GryposDE/Snail_v1/FV_Snail_v1.png

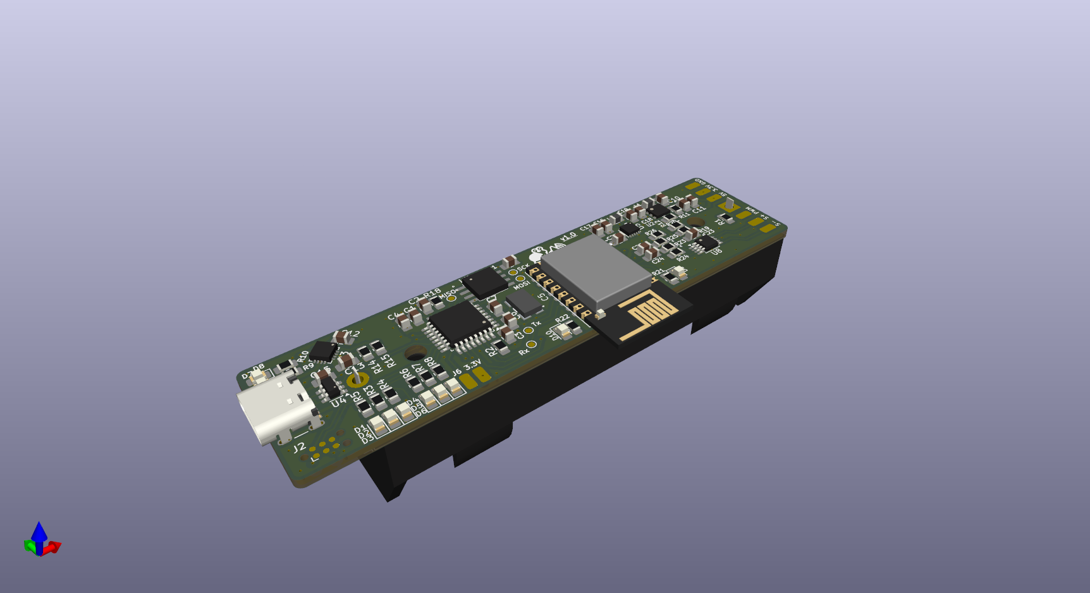
FV_Snail_v1.png
