GryposDE/Snail_v1/BV_Snail_v1.png

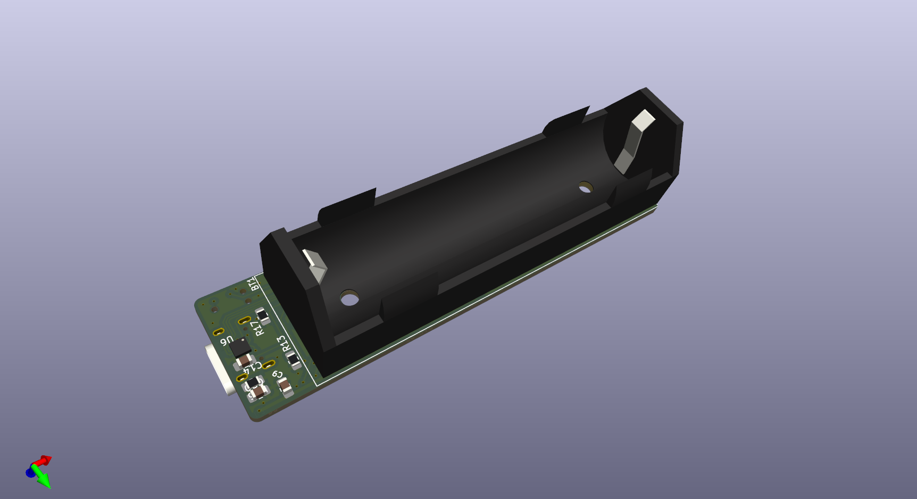
BV_Snail_v1.png
