GryposDE/Snail_v1/CADs/LIB_830059539/830059539/3D/830059539.stp

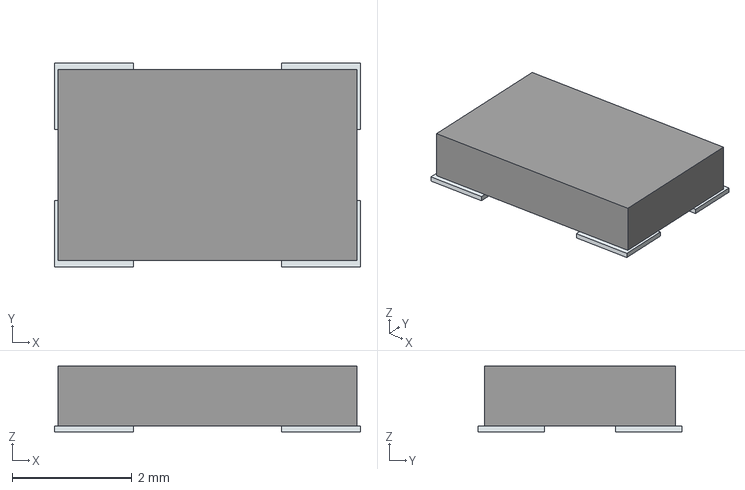
[picture p3: CAD file, 2026-04-04]
CADs/LIB_830059539/830059539/3D/830059539.stp
5.12 x 3.42 x 1.10 mm
Pins
