GryposDE/Snail_v1/CADs/LIB_TLV61070A/TLV61070ADBVR/3D/TLV61070ADBVR.stp

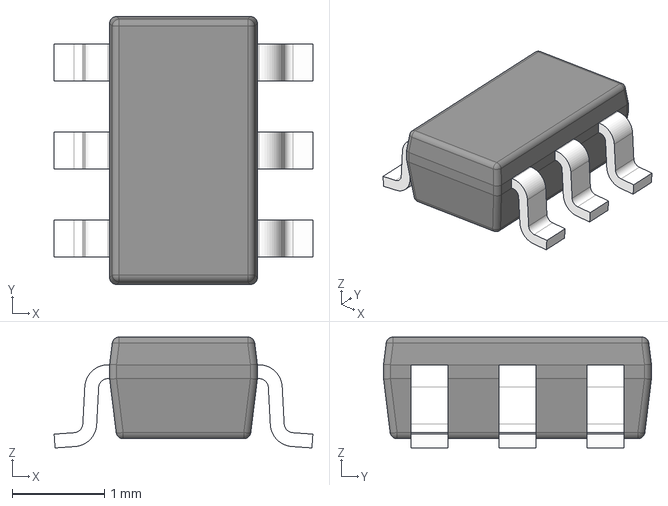
[picture p4: CAD file, 2026-04-05]
CADs/LIB_TLV61070A/TLV61070ADBVR/3D/TLV61070ADBVR.stp
2.80 x 2.90 x 1.20 mm
BODY-SOT
LEAD-SOT x 6
