GryposDE/Snail_v1/(list of files, cad)

Other CAD files:
CADs/LIB_830059539/830059539/Allegro/830059539.psm
CADs/LIB_830059539/830059539/DEHDL/830059539/chips/chips.prt
CADs/LIB_TLV61070A/TLV61070ADBVR/Allegro/sot95p280x145-6n.psm
CADs/LIB_TLV61070A/TLV61070ADBVR/DEHDL/tlv61070adbvr/chips/chips.prt
