GryposDE/Snail_v1/(list of files, drawings)

Other design files:
CADs/LIB_TLV61070A/TLV61070ADBVR/Altium/SOT95P280X145-6N.PcbLib
CADs/LIB_TLV61070A/TLV61070ADBVR/Altium/TLV61070ADBVR.SchLib
