GryposDE/Snail_v1/Snail_v1.kicad_pcb

## KiCad design Snail_v1.kicad_pcb (2026-04-18)

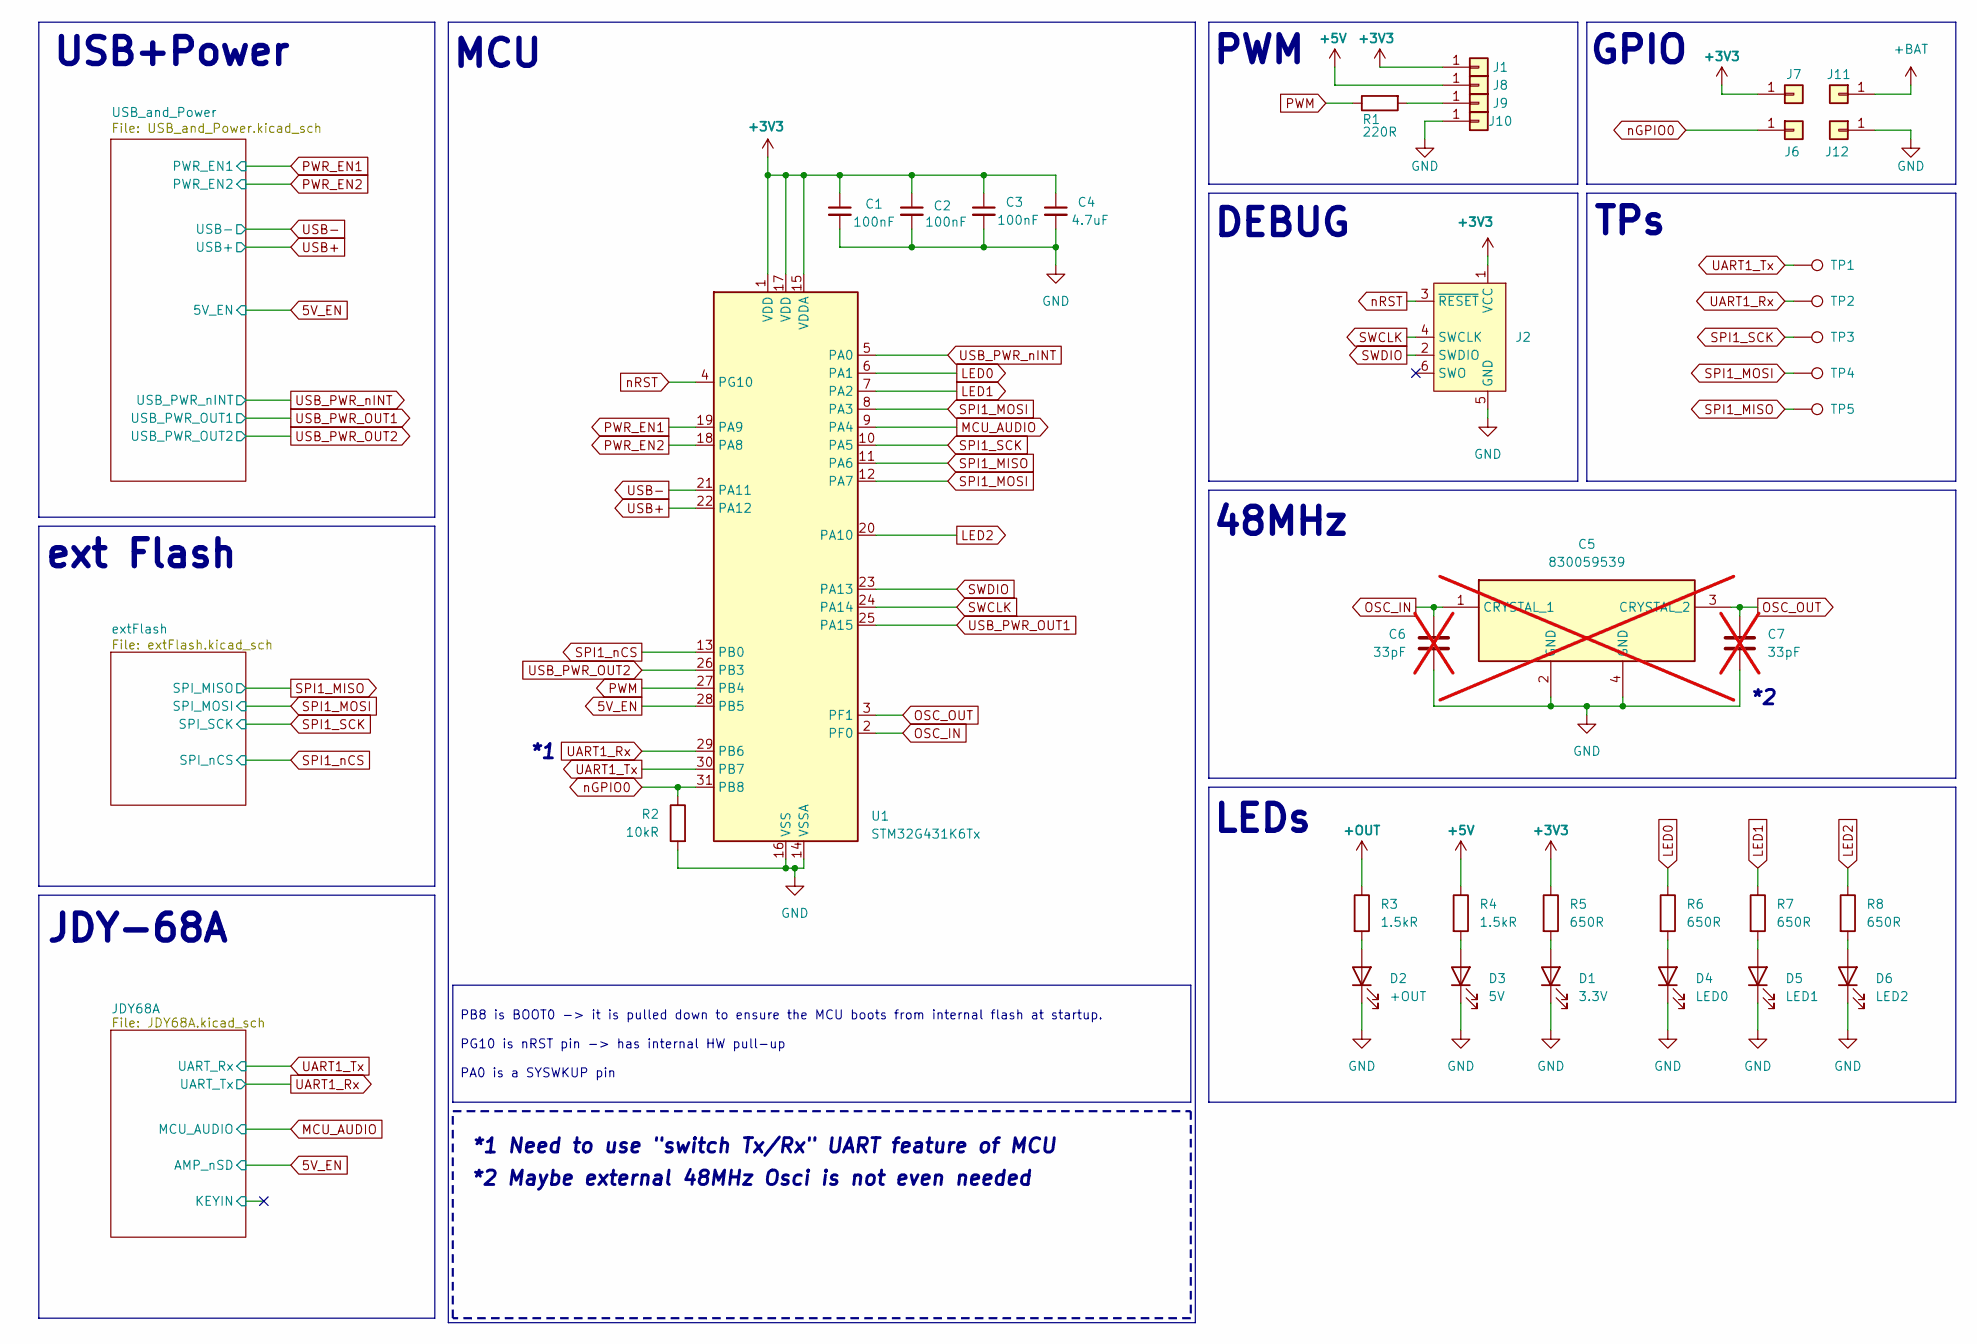
[picture p9: schematic Snail_v1.kicad_sch, Snail v1]

Parts:
C1, C2, C3: 100nF; C_0805_2012Metric_Pad1.18x1.45mm_HandSolder
C4: 4.7uF; C_0805_2012Metric_Pad1.18x1.45mm_HandSolder
C5: 830059539; Mouser Part Number 710-830059539; not fitted
C6, C7: 33pF; C_0805_2012Metric_Pad1.18x1.45mm_HandSolder; not fitted
D1: 3.3V; LED_0805_2012Metric_Pad1.15x1.40mm_HandSolder
D2: +OUT; LED_0805_2012Metric_Pad1.15x1.40mm_HandSolder
D3: 5V; LED_0805_2012Metric_Pad1.15x1.40mm_HandSolder
D4: LED0; LED_0805_2012Metric_Pad1.15x1.40mm_HandSolder
D5: LED1; LED_0805_2012Metric_Pad1.15x1.40mm_HandSolder
D6: LED2; LED_0805_2012Metric_Pad1.15x1.40mm_HandSolder
J1, J6, J7, J8, J9, J10, J11, J12: Conn_01x01; SolderWirePad_1x01_SMD_1.5x3mm
J2: Conn_ARM_SWD_TagConnect_TC2030-NL; Tag-Connect_TC2030-IDC-NL_2x03_P1.27mm_Vertical
R1: 220R; R_0805_2012Metric_Pad1.20x1.40mm_HandSolder
R2: 10kR; R_0805_2012Metric_Pad1.20x1.40mm_HandSolder
R3, R4: 1.5kR; R_0805_2012Metric_Pad1.20x1.40mm_HandSolder
R5, R6, R7, R8: 650R; R_0805_2012Metric_Pad1.20x1.40mm_HandSolder
TP1, TP2, TP3, TP4, TP5: TestPoint; TestPoint_Pad_D1.0mm
U1: STM32G431K6Tx; LQFP-32_7x7mm_P0.8mm

Connections:
5V_EN: U1.28 (PB5); also elsewhere on the board
+3V3: C1.1, C2.1, C3.1, C4.1, J1.1, J2.1 (VCC), J7.1, R5.1, U1.1 (VDD), U1.15 (VDDA), U1.17 (VDD); also elsewhere on the board
+5V: J8.1, R4.1; also elsewhere on the board
+OUT: R3.1; also elsewhere on the board
GND: C1.2, C2.2, C3.2, C4.2, C5.2 (GND), C5.4 (GND), C6.2, C7.2, D1.1 (K), D2.1 (K), D3.1 (K), D4.1 (K), D5.1 (K), D6.1 (K), J2.5 (GND), J10.1, J12.1, R2.2, U1.14 (VSSA), U1.16 (VSS), U1.32 (VSS); also elsewhere on the board
LED0: R6.1, U1.6 (PA1)
LED1: R7.1, U1.7 (PA2)
LED2: R8.1, U1.20 (PA10)
MCU_AUDIO: U1.9 (PA4); also elsewhere on the board
unnamed: D1.2 (A), R5.2
unnamed: D2.2 (A), R3.2
unnamed: D3.2 (A), R4.2
unnamed: D4.2 (A), R6.2
unnamed: D5.2 (A), R7.2
unnamed: D6.2 (A), R8.2
unnamed: J9.1, R1.2
OSC_IN: C5.1 (CRYSTAL_1), C6.1, U1.2 (PF0)
OSC_OUT: C5.3 (CRYSTAL_2), C7.1, U1.3 (PF1)
PWM: R1.1, U1.27 (PB4)
PWR_EN1: U1.19 (PA9); also elsewhere on the board
PWR_EN2: U1.18 (PA8); also elsewhere on the board
SPI1_MISO: TP5.1, U1.11 (PA6); also elsewhere on the board
SPI1_MOSI: TP4.1, U1.8 (PA3), U1.12 (PA7); also elsewhere on the board
SPI1_SCK: TP3.1, U1.10 (PA5); also elsewhere on the board
SPI1_nCS: U1.13 (PB0); also elsewhere on the board
SWCLK: J2.4 (SWCLK), U1.24 (PA14)
SWDIO: J2.2 (SWDIO), U1.23 (PA13)
UART1_Rx: TP2.1, U1.29 (PB6); also elsewhere on the board
UART1_Tx: TP1.1, U1.30 (PB7); also elsewhere on the board
USB+: U1.22 (PA12); also elsewhere on the board
USB-: U1.21 (PA11); also elsewhere on the board
USB_PWR_OUT1: U1.25 (PA15); also elsewhere on the board
USB_PWR_OUT2: U1.26 (PB3); also elsewhere on the board
USB_PWR_nINT: U1.5 (PA0); also elsewhere on the board
nGPIO0: J6.1, R2.1, U1.31 (PB8); also elsewhere on the board
nRST: J2.3 (~RESET), U1.4 (PG10)

Notes on the sheet:
*2 Maybe external 48MHz Osci is not even needed
ext Flash
USB+Power
DEBUG
TPs
LEDs
JDY-68A
*1 Need to use "switch Tx/Rx" UART feature of MCU
MCU
PWM
GPIO
48MHz
PB8 is BOOT0 -> it is pulled down to ensure the MCU boots from internal flash at startup. PG10 is nRST pin -> has internal HW pull-up PA0 is a SYSWKUP pin

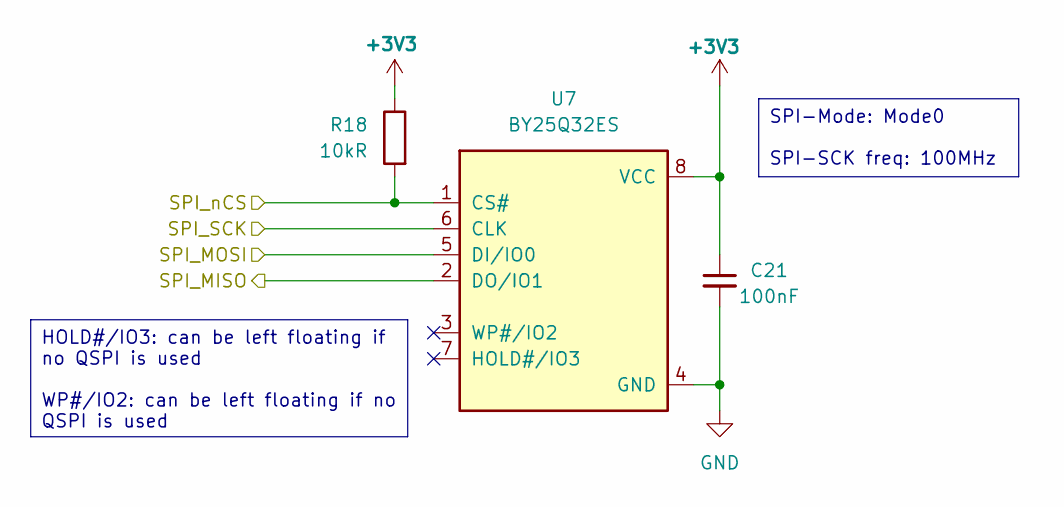
[picture p10: schematic extFlash.kicad_sch, Snail v1]

Parts:
C21: 100nF; C_0805_2012Metric_Pad1.18x1.45mm_HandSolder
R18: 10kR; R_0805_2012Metric_Pad1.20x1.40mm_HandSolder
U7: BY25Q32ES; BY25Q32ESSIG_SOIC-8_208mil

Connections:
+3V3: C21.1, R18.1, U7.8 (VCC); also elsewhere on the board
GND: C21.2, U7.4 (GND); also elsewhere on the board
SPI1_MISO: U7.2 (DO/IO1); also elsewhere on the board
SPI1_MOSI: U7.5 (DI/IO0); also elsewhere on the board
SPI1_SCK: U7.6 (CLK); also elsewhere on the board
SPI1_nCS: R18.2, U7.1 (CS#); also elsewhere on the board

Notes on the sheet:
SPI-Mode: Mode0 SPI-SCK freq: 100MHz
HOLD#/IO3: can be left floating if no QSPI is used WP#/IO2: can be left floating if no QSPI is used

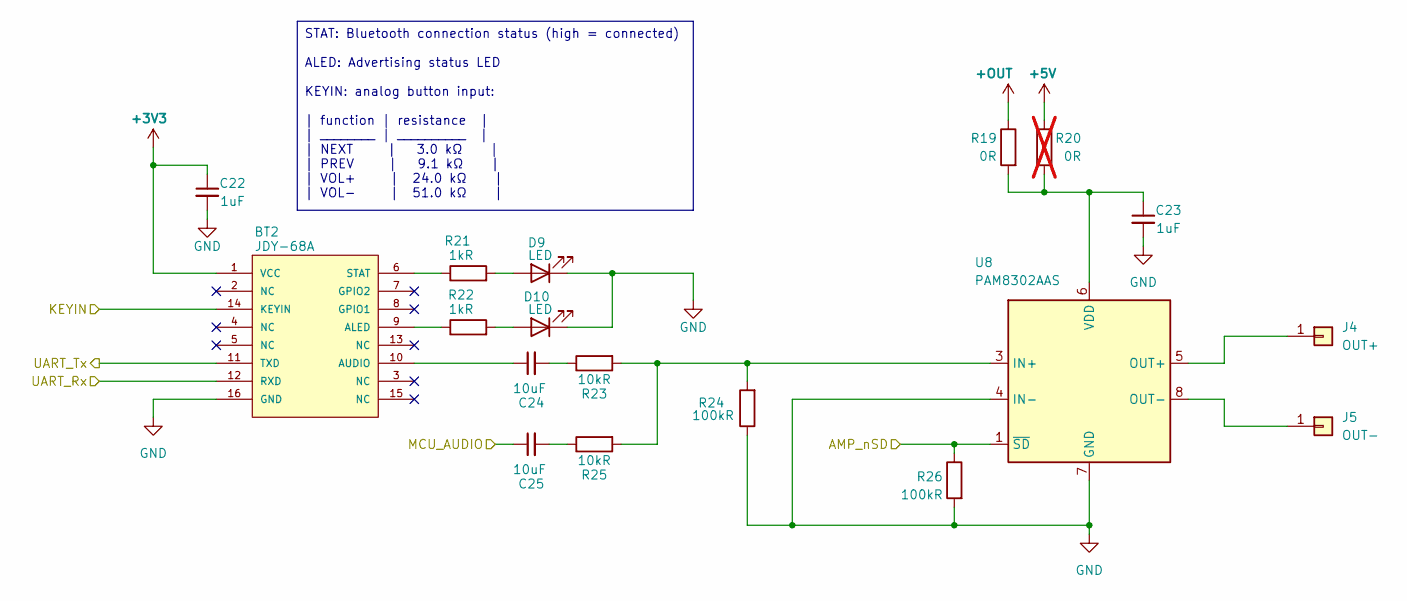
[picture p11: schematic JDY68A.kicad_sch, Snail v1]

Parts:
BT2: JDY-68A; JDY-68A_Module
C22, C23: 1uF; C_0805_2012Metric_Pad1.18x1.45mm_HandSolder
C24, C25: 10uF; C_0805_2012Metric_Pad1.18x1.45mm_HandSolder
D9, D10: LED; LED_0805_2012Metric_Pad1.15x1.40mm_HandSolder
J4: OUT+; SolderWirePad_1x01_SMD_1.5x3mm
J5: OUT-; SolderWirePad_1x01_SMD_1.5x3mm
R19: 0R; R_0805_2012Metric_Pad1.20x1.40mm_HandSolder
R20: 0R; R_0805_2012Metric_Pad1.20x1.40mm_HandSolder; not fitted
R21, R22: 1kR; R_0805_2012Metric_Pad1.20x1.40mm_HandSolder
R23, R25: 10kR; R_0805_2012Metric_Pad1.20x1.40mm_HandSolder
R24, R26: 100kR; R_0805_2012Metric_Pad1.20x1.40mm_HandSolder
U8: PAM8302AAS; MSOP-8_3x3mm_P0.65mm

Connections:
5V_EN: R26.1, U8.1 (~SD); also elsewhere on the board
+3V3: BT2.1 (VCC), C22.1; also elsewhere on the board
+5V: R20.1; also elsewhere on the board
+OUT: R19.1; also elsewhere on the board
/JDY68A/KEYIN: BT2.14 (KEYIN)
GND: BT2.16 (GND), C22.2, C23.2, D9.1 (K), D10.1 (K), R24.1, R26.2, U8.4 (IN-), U8.7 (GND); also elsewhere on the board
MCU_AUDIO: C25.1; also elsewhere on the board
unnamed: BT2.9 (ALED), R22.1
unnamed: BT2.10 (AUDIO), C24.1
unnamed: BT2.6 (STAT), R21.1
unnamed: C24.2, R23.1
unnamed: C25.2, R25.1
unnamed: D9.2 (A), R21.2
unnamed: D10.2 (A), R22.2
unnamed: J4.1, U8.5 (OUT+)
unnamed: J5.1, U8.8 (OUT-)
unnamed: R23.2, R24.2, R25.2, U8.3 (IN+)
unnamed: C23.1, R19.2, R20.2, U8.6 (VDD)
UART1_Rx: BT2.11 (TXD); also elsewhere on the board
UART1_Tx: BT2.12 (RXD); also elsewhere on the board

Notes on the sheet:
STAT: Bluetooth connection status (high = connected) ALED: Advertising status LED KEYIN: analog button input: | function | resistance | | ________ | __________ | | NEXT | 3.0 kΩ | | PREV | 9.1 kΩ | | VOL+ | 24.0 kΩ | | VOL− | 51.0 kΩ |

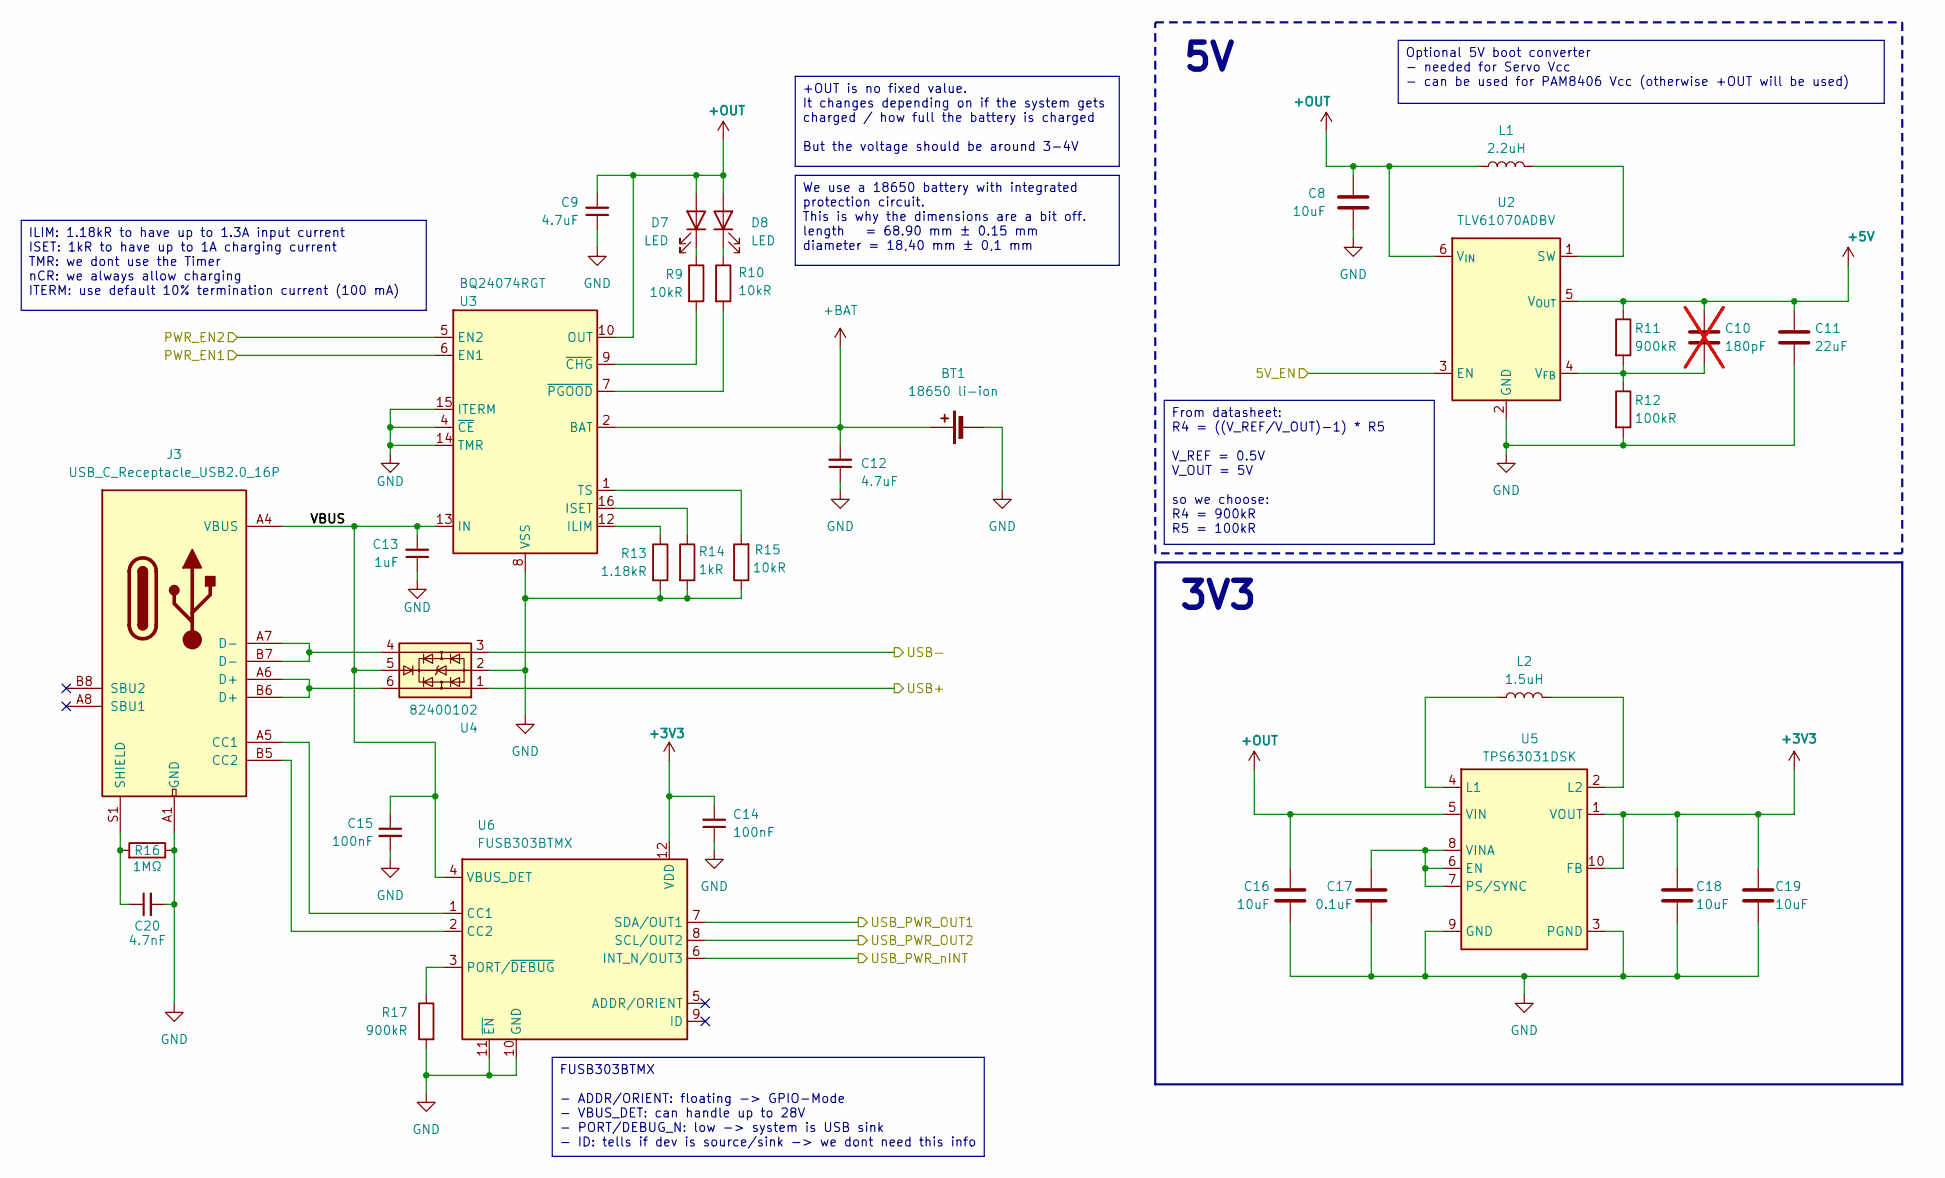
[picture p12: schematic USB_and_Power.kicad_sch, Snail v1]

Parts:
BT1: 18650 li-ion; BatteryHolder_MPD_BH-18650-PC
C8, C16, C18, C19: 10uF; C_0805_2012Metric_Pad1.18x1.45mm_HandSolder
C9, C12: 4.7uF; C_0805_2012Metric_Pad1.18x1.45mm_HandSolder
C10: 180pF; C_0805_2012Metric_Pad1.18x1.45mm_HandSolder; not fitted
C11: 22uF; C_0805_2012Metric_Pad1.18x1.45mm_HandSolder
C13: 1uF; C_0805_2012Metric_Pad1.18x1.45mm_HandSolder
C14, C15: 100nF; C_0805_2012Metric_Pad1.18x1.45mm_HandSolder
C17: 0.1uF; C_0805_2012Metric_Pad1.18x1.45mm_HandSolder
C20: 4.7nF; C_0805_2012Metric_Pad1.18x1.45mm_HandSolder
D7, D8: LED; LED_0805_2012Metric_Pad1.15x1.40mm_HandSolder
J3: USB_C_Receptacle_USB2.0_16P; USB_C_Receptacle_GCT_USB4105-xx-A_16P_TopMnt_Horizontal
L1: 2.2uH; L_0805_2012Metric_Pad1.05x1.20mm_HandSolder
L2: 1.5uH; L_0805_2012Metric_Pad1.05x1.20mm_HandSolder
R9, R10, R15: 10kR; R_0805_2012Metric_Pad1.20x1.40mm_HandSolder
R11, R17: 900kR; R_0805_2012Metric_Pad1.20x1.40mm_HandSolder
R12: 100kR; R_0805_2012Metric_Pad1.20x1.40mm_HandSolder
R13: 1.18kR; R_0805_2012Metric_Pad1.20x1.40mm_HandSolder
R14: 1kR; R_0805_2012Metric_Pad1.20x1.40mm_HandSolder
R16: 1MΩ; R_0805_2012Metric_Pad1.20x1.40mm_HandSolder
U2: TLV61070ADBV; SOT95P280X145-6N
U3: BQ24074RGT; VQFN-16-1EP_3x3mm_P0.5mm_EP1.6x1.6mm
U4: 82400102; SOT-23-6
U5: TPS63031DSK; WSON-10-1EP_2.5x2.5mm_P0.5mm_EP1.2x2mm
U6: FUSB303BTMX; Texas_X2QFN-12_1.6x1.6mm_P0.4mm

Connections:
5V_EN: U2.3 (EN); also elsewhere on the board
+3V3: C14.2, C18.1, C19.1, U5.1 (VOUT), U5.10 (FB), U6.12 (VDD); also elsewhere on the board
+5V: C10.1, C11.1, R11.1, U2.5 (V_{OUT}); also elsewhere on the board
+BAT: BT1.1 (+), C12.2, U3.2 (BAT), U3.3 (BAT); also elsewhere on the board
+OUT: C8.1, C9.2, C16.1, D7.2 (A), D8.2 (A), L1.1, U2.6 (V_{IN}), U3.10 (OUT), U3.11 (OUT), U5.5 (VIN); also elsewhere on the board
/USB_and_Power/VBUS: C13.2, C15.1, J3.A4 (VBUS), J3.A9 (VBUS), J3.B4 (VBUS), J3.B9 (VBUS), U3.13 (IN), U4.5, U6.4 (VBUS_DET)
GND: BT1.2 (-), C8.2, C9.1, C11.2, C12.1, C13.1, C14.1, C15.2, C16.2, C17.2, C18.2, C19.2, C20.2, J3.A1 (GND), J3.A12 (GND), J3.B1 (GND), J3.B12 (GND), R12.2, R13.2, R14.2, R15.1, R16.1, R17.2, U2.2 (GND), U3.4 (~CE), U3.8 (VSS), U3.14 (TMR), U3.15 (ITERM), U3.17 (VSS), U4.2, U5.3 (PGND), U5.9 (GND), U6.10 (GND), U6.11 (~EN); also elsewhere on the board
unnamed: D7.1 (K), R9.1
unnamed: D8.1 (K), R10.1
unnamed: J3.A5 (CC1), U6.1 (CC1)
unnamed: J3.B5 (CC2), U6.2 (CC2)
unnamed: J3.A6 (D+), J3.B6 (D+), U4.6
unnamed: J3.A7 (D-), J3.B7 (D-), U4.4
unnamed: C20.1, J3.S1 (SHIELD), R16.2
unnamed: L1.2, U2.1 (SW)
unnamed: C10.2, R11.2, R12.1, U2.4 (V_{FB})
unnamed: R13.1, U3.12 (ILIM)
unnamed: R14.1, U3.16 (ISET)
unnamed: R15.2, U3.1 (TS)
unnamed: R9.2, U3.9 (~CHG)
unnamed: R10.2, U3.7 (~PGOOD)
unnamed: C17.1, U5.6 (EN), U5.7 (PS/SYNC), U5.8 (VINA)
unnamed: L2.1, U5.4 (L1)
unnamed: L2.2, U5.2 (L2)
unnamed: R17.1, U6.3 (PORT/~DEBUG)
PWR_EN1: U3.6 (EN1); also elsewhere on the board
PWR_EN2: U3.5 (EN2); also elsewhere on the board
USB+: U4.1; also elsewhere on the board
USB-: U4.3; also elsewhere on the board
USB_PWR_OUT1: U6.7 (SDA/OUT1); also elsewhere on the board
USB_PWR_OUT2: U6.8 (SCL/OUT2); also elsewhere on the board
USB_PWR_nINT: U6.6 (INT_N/OUT3); also elsewhere on the board

Notes on the sheet:
3V3
ILIM: 1.18kR to have up to 1.3A input current ISET: 1kR to have up to 1A charging current TMR: we dont use the Timer nCR: we always allow charging ITERM: use default 10% termination current (100 mA)
From datasheet: R4 = ((V_REF /V_OUT)  −1) * R5 V_REF = 0.5V V_OUT = 5V so we choose: R4 = 900kR R5 = 100kR
FUSB303BTMX - ADDR/ORIENT: floating -> GPIO-Mode - VBUS_DET: can handle up to 28V - PORT/DEBUG_N: low -> system is USB sink - ID: tells if dev is source/sink -> we dont need this info
We use a 18650 battery with integrated protection circuit. This is why the dimensions are a bit off. length = 68.90 mm ± 0.15 mm diameter = 18,40 mm ± 0,1 mm
+OUT is no fixed value. It changes depending on if the system gets charged / how full the battery is charged But the voltage should be around 3-4V
Optional 5V boot converter - needed for Servo Vcc - can be used for PAM8406 Vcc (otherwise +OUT will be used)

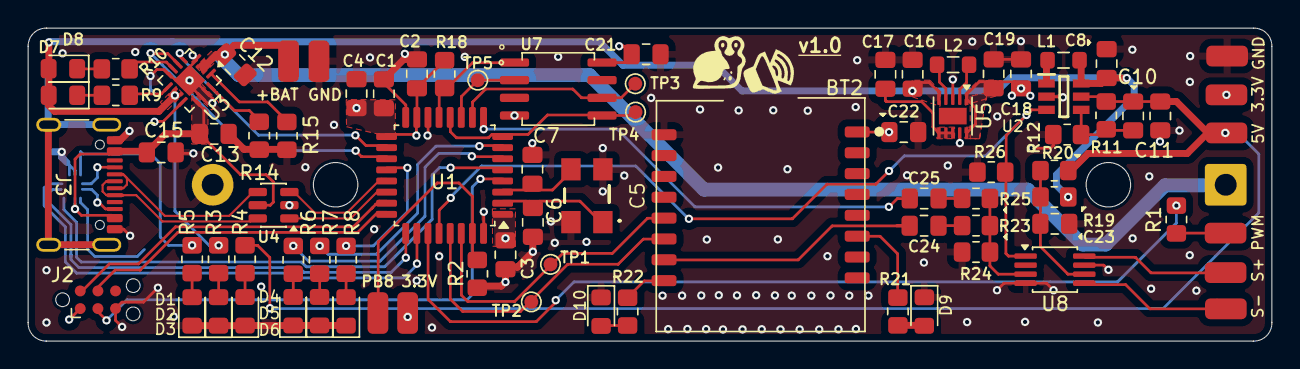
[picture p13: board Snail_v1.kicad_pcb from above]

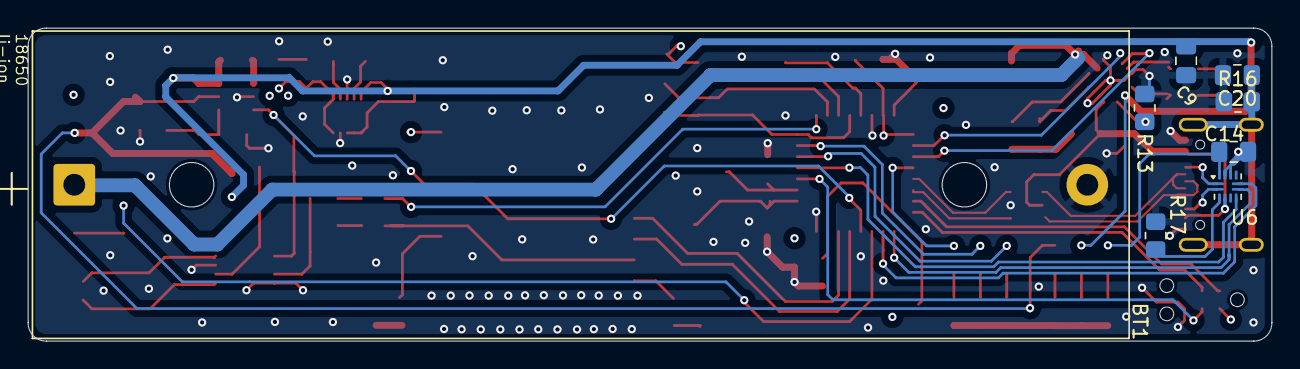
[picture p14: board Snail_v1.kicad_pcb from below]

Board: 4 copper layers, 89.5 x 22.5 mm, 90 parts (8 on the bottom side), 67 nets.

Other parts of the board:
3.3V: Conn_01x01; SolderWirePad_1x01_SMD_1.5x3mm
+BAT: Conn_01x01; SolderWirePad_1x01_SMD_1.5x3mm
GND: Conn_01x01; SolderWirePad_1x01_SMD_1.5x3mm
PB8: Conn_01x01; SolderWirePad_1x01_SMD_1.5x3mm

Their connections:
+3V3: 3.3V.1; also elsewhere on the board
+BAT: +BAT.1; also elsewhere on the board
GND: GND.1; also elsewhere on the board
nGPIO0: PB8.1; also elsewhere on the board
