GryposDE/Snail_v1/(commit log)

2026-03-28 Added USB+Power circuit
    [Snail_v1.kicad_pcb, Snail_v1.kicad_sch, USB_and_Power.kicad_sch]
2026-03-29 Added 5V, 3V3, PAM circuit
    [Snail_v1.kicad_sch, USB_and_Power.kicad_sch]
2026-04-04 Added BY25Q32 extFlash
    [Snail_v1.kicad_sch, USB_and_Power.kicad_sch, by25q32es_reference.kicad_sch, extFlash.kicad_sch]
2026-04-04 Added JDY-68A and replaced Amp-IC for PAM8302AAS
    [JDY68A.kicad_sch, Snail_v1.kicad_sch]
2026-04-04 Changed LDO to Buc-Boost
    [JDY68A.kicad_sch, Snail_v1.kicad_sch, USB_and_Power.kicad_sch, extFlash.kicad_sch]
2026-04-04 Added LEDs + TPs
    [JDY68A.kicad_sch, Snail_v1.kicad_sch, USB_and_Power.kicad_sch]
2026-04-04 Added missing footprints
    [Snail_v1.kicad_sch]
2026-04-04 Started with layout
    [830059539.psm, 830059539.stp, EDI2CAP.CFG, Snail_v1.kicad_pcb, Snail_v1.kicad_sch, USB_and_Power.kicad_sch, chips.prt, extFlash.kicad_sch]
2026-04-05 Added layout
    [EDI2CAP.CFG, JDY68A.kicad_sch, SOT95P280X145-6N.PcbLib, Snail_v1.kicad_pcb, Snail_v1.kicad_sch, TLV61070ADBVR.SchLib, TLV61070ADBVR.stp, USB_and_Power.kicad_sch]
2026-04-06 Did Silkscreen + added images of PCBA
    [JDY68A.kicad_sch, Snail_v1.kicad_pcb, Snail_v1.kicad_sch, USB_and_Power.kicad_sch, extFlash.kicad_sch]
2026-04-06 Added missing AMP_nSD connection to MCU via 5V_EN
    [JDY68A.kicad_sch, Snail_v1.kicad_pcb, Snail_v1.kicad_sch, USB_and_Power.kicad_sch, extFlash.kicad_sch]
2026-04-06 Added rounded corners to PCB
    [Snail_v1.kicad_pcb]
2026-04-08 Changed layout + added dimensions
    [JDY68A.kicad_sch, Snail_v1.kicad_pcb, Snail_v1.kicad_sch]
2026-04-18 Added +BAT and GND Pad to design
    [Snail_v1.kicad_pcb, Snail_v1.kicad_sch, USB_and_Power.kicad_sch]
